BeenJammmin47/TROLL_E/Daniel/Daniel_Building_Frame1.jpg

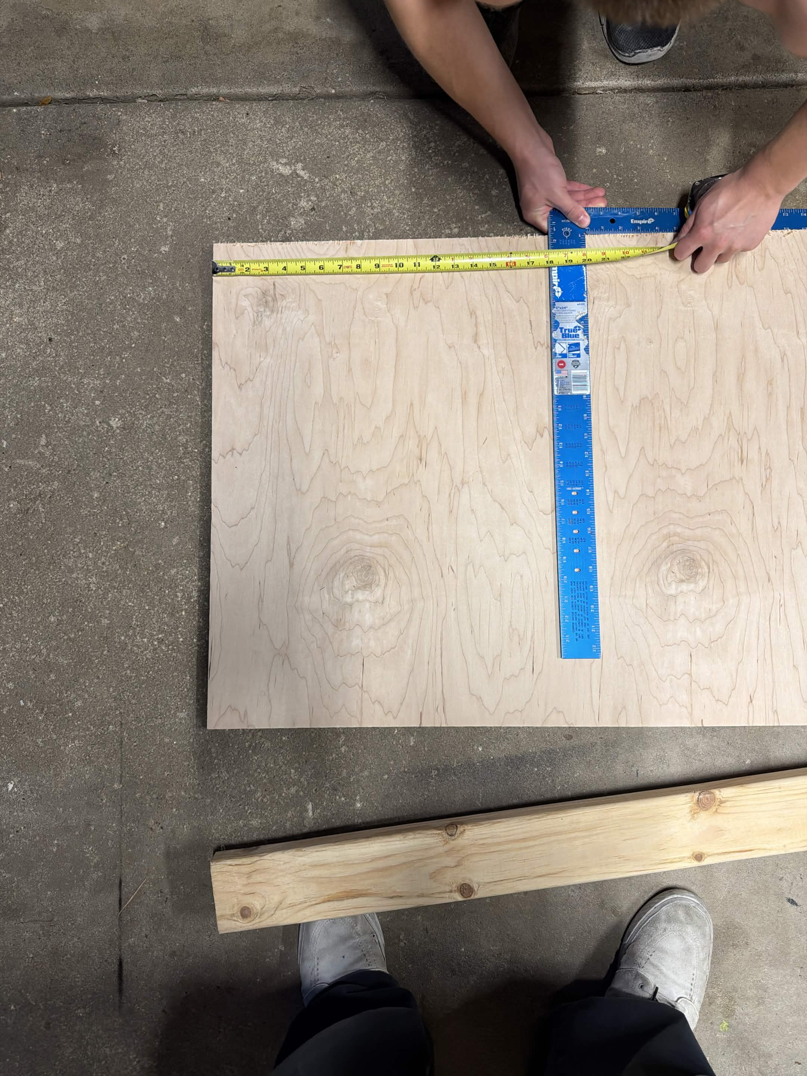
Daniel/Daniel_Building_Frame1.jpg
