BeenJammmin47/TROLL_E/Daniel/Daniel_Building_Frame2.jpg

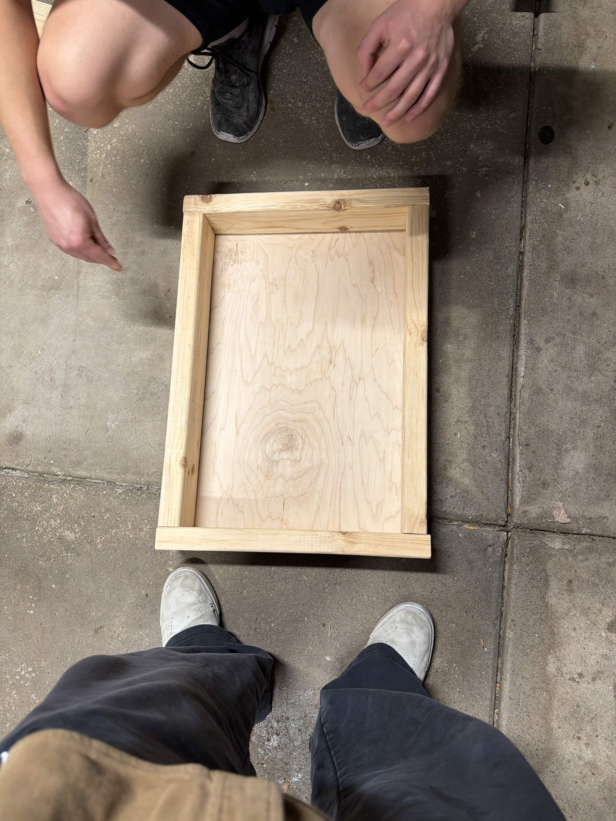
Daniel/Daniel_Building_Frame2.jpg
