BeenJammmin47/TROLL_E/README.md

# TROLL_E
ECE 445 Team 25 TROLL E: Tracked Robotic Outdoor Load-Lugging Escort

This is the Senior Design Project for Ben Wang, Daniel Ly, and Hyun Been (Robin) Park.

The goal of this project is to develop an autonomous following vehicle that can carry a load of 20 lbs and is able to detect obstacles and navigate around them.
