BeenJammmin47/TROLL_E/Design Doc/troll_e_state_machine_flowchart.png

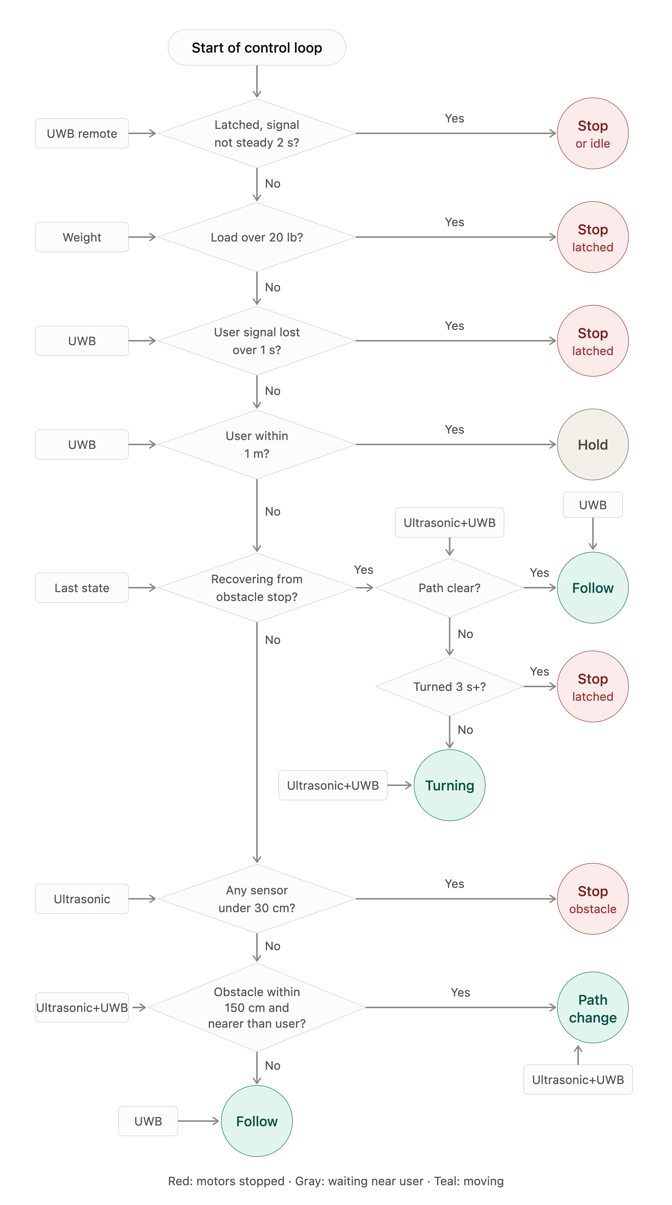
Design Doc/troll_e_state_machine_flowchart.png
