BeenJammmin47/TROLL_E/Design Doc/TROLL_E_System_Block Diagram.png

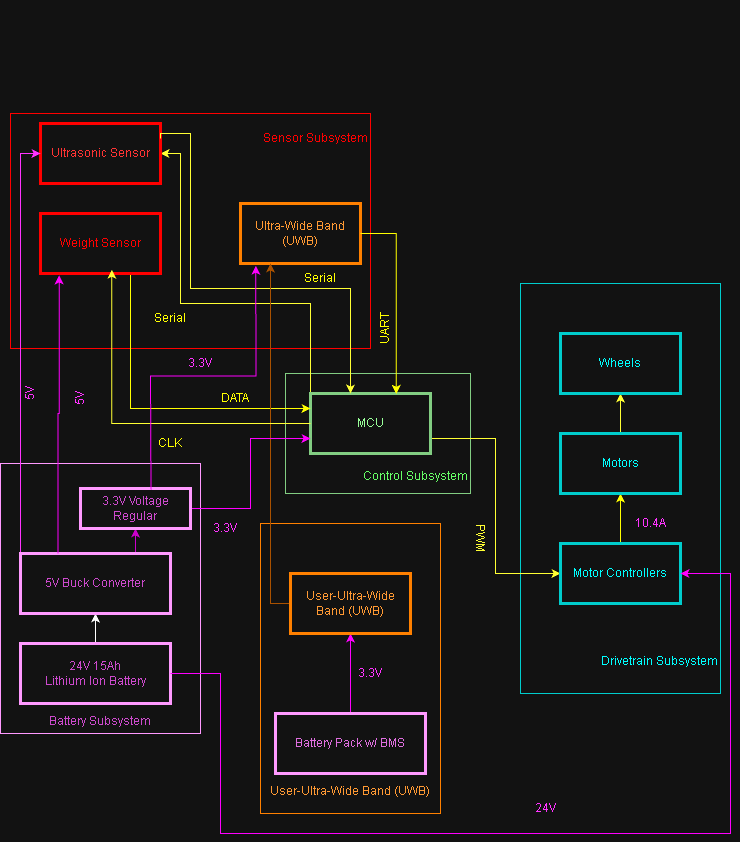
Design Doc/TROLL_E_System_Block Diagram.png
