BeenJammmin47/TROLL_E/Proposal/Proposal_Initial_Visual.png

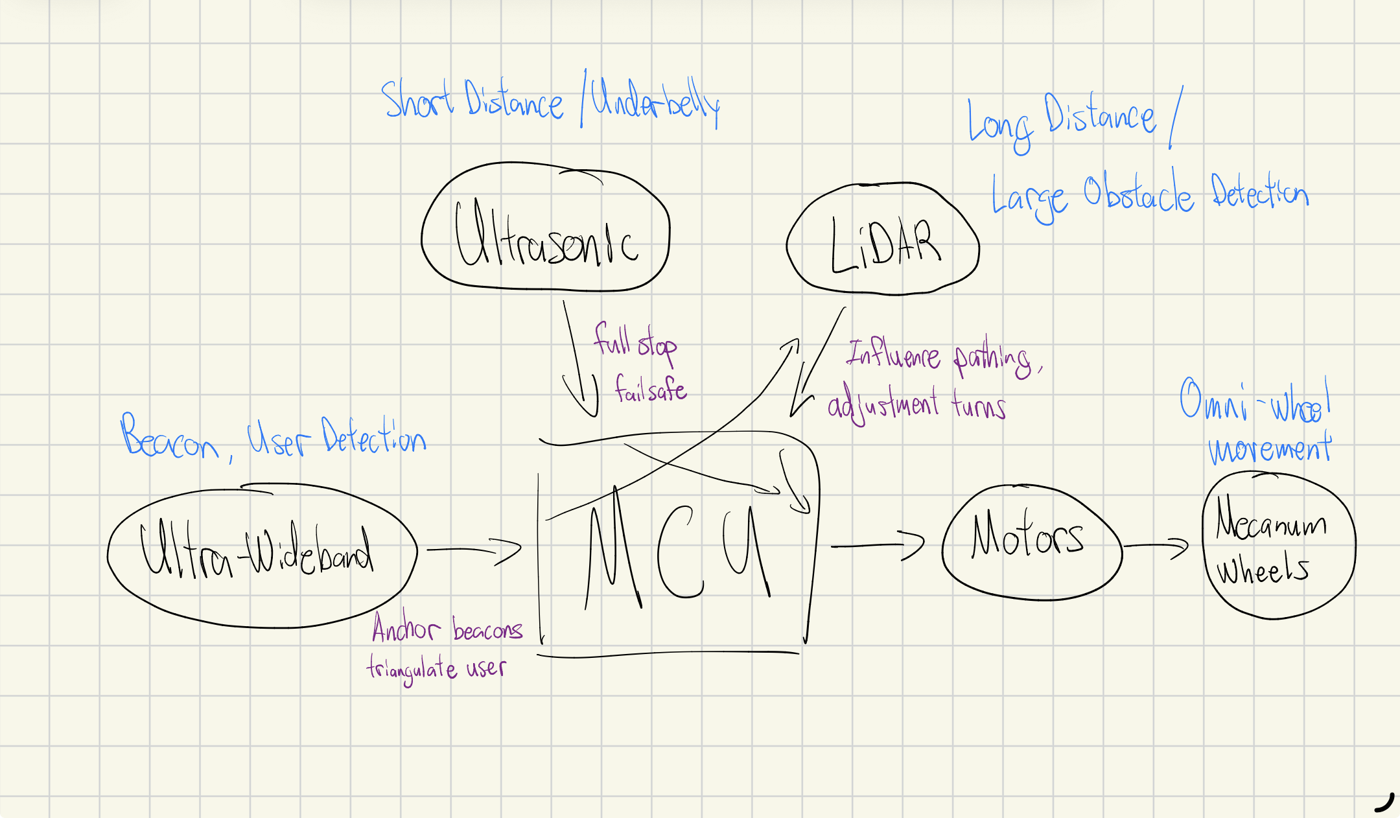
Proposal/Proposal_Initial_Visual.png
