BeenJammmin47/TROLL_E/Robin/445proposaldiagram.png

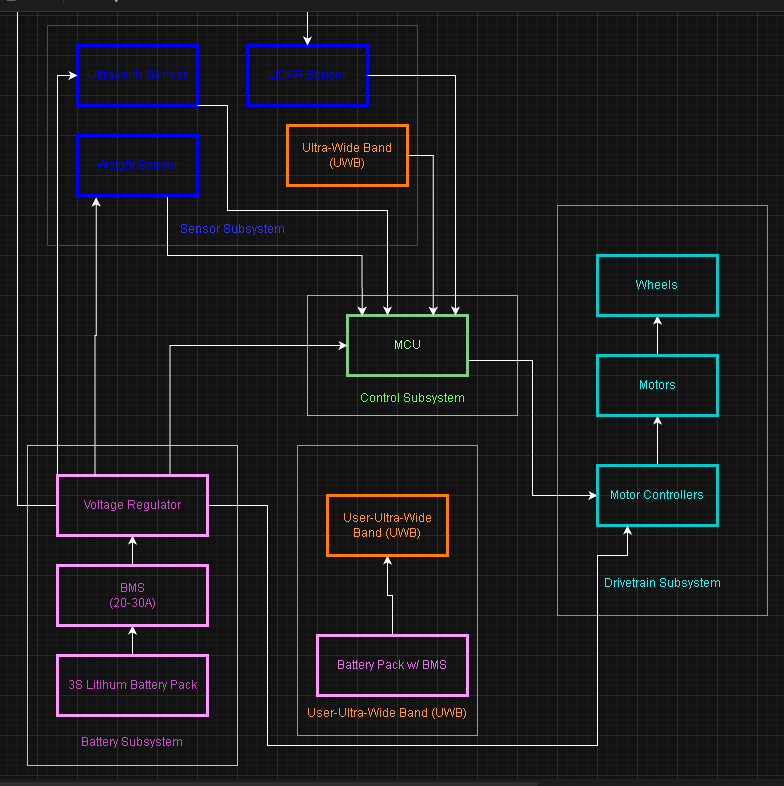
Robin/445proposaldiagram.png
